alibij/SolderingIronController/Schematic.pdf

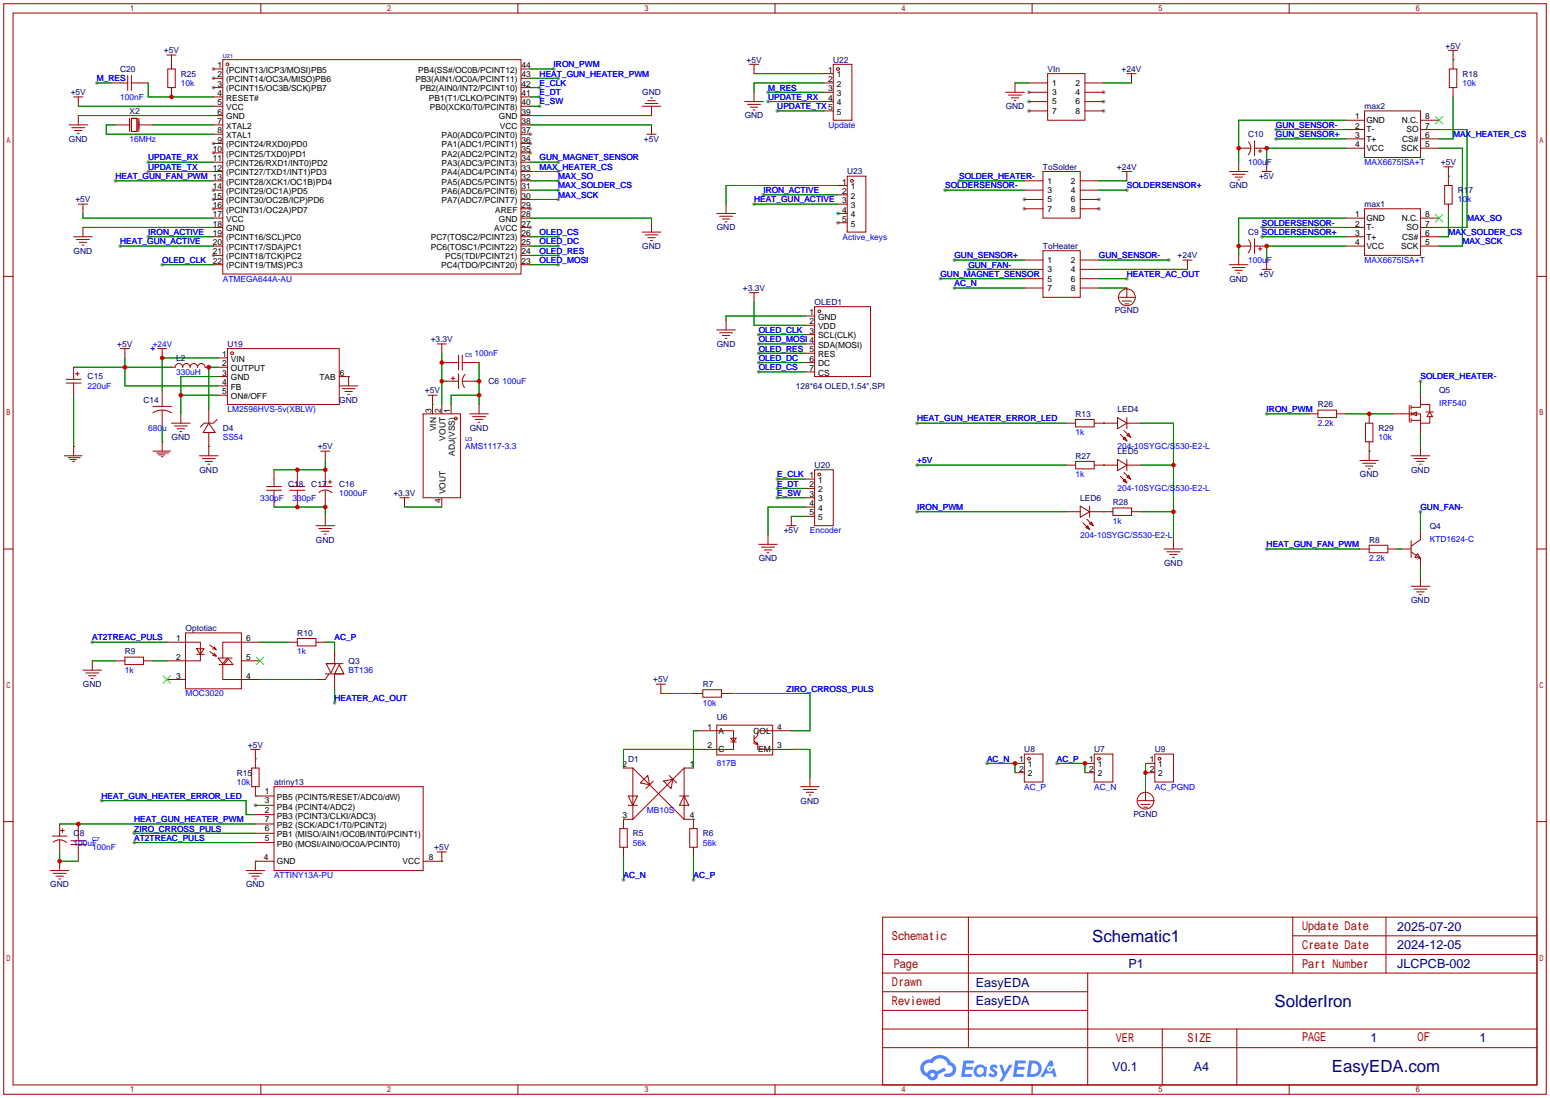
[picture p3: page 1]
