alibij/SolderingIronController/PCB.pdf

J1

R5 | Q4 R⁶ | R7

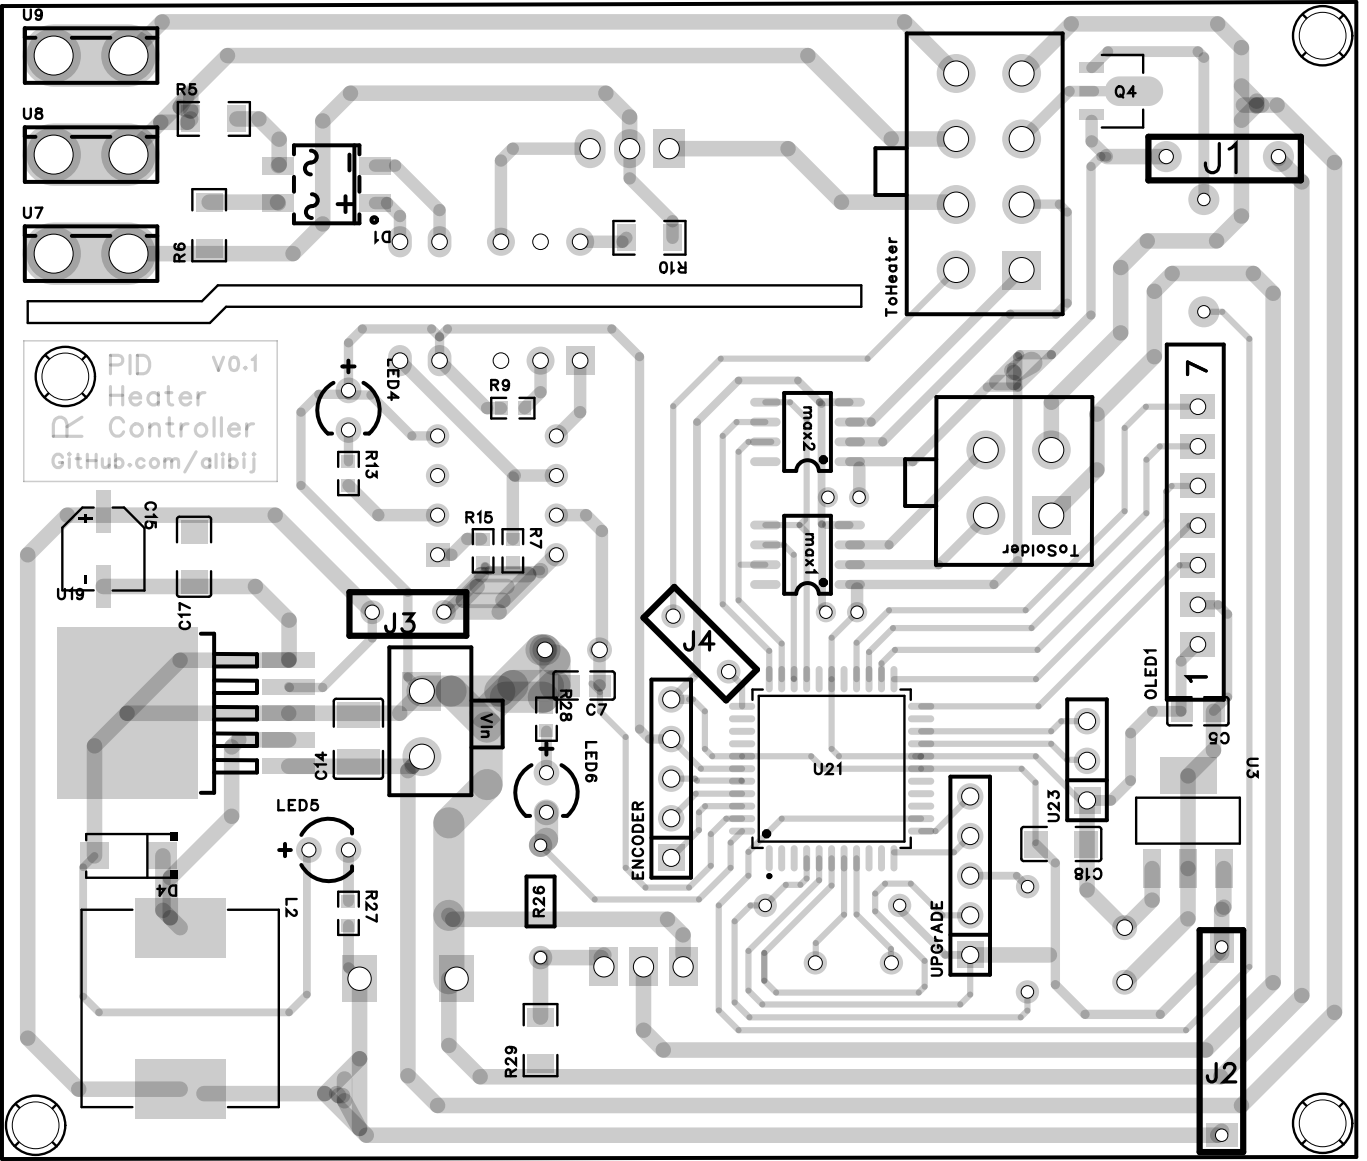
[picture p4: page 1]

# Optotiac

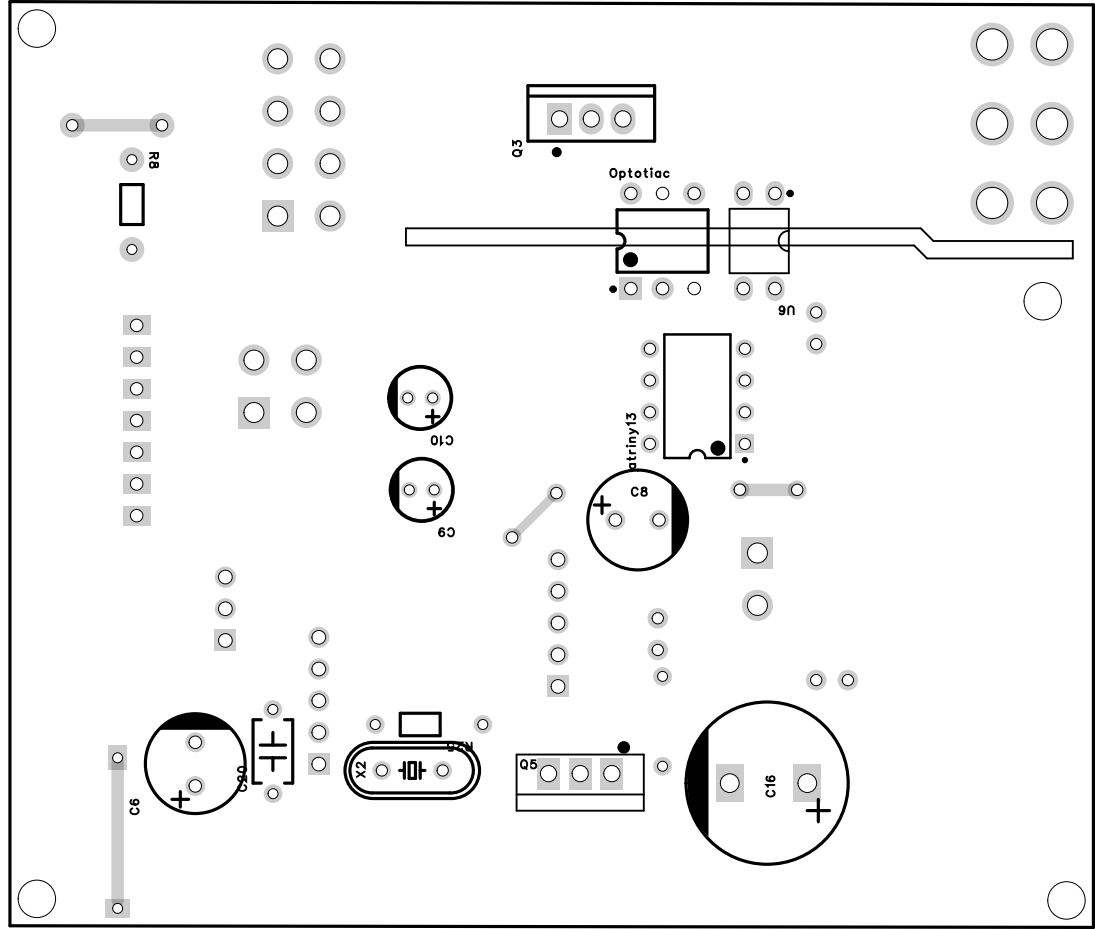
[picture p5: page 2]

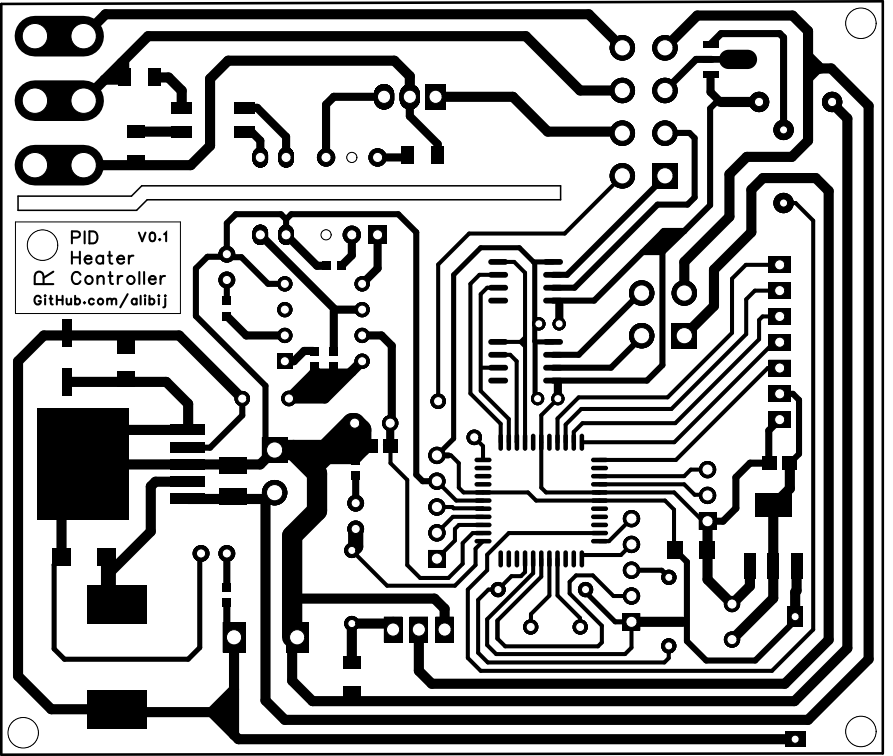
[picture p6: page 3]

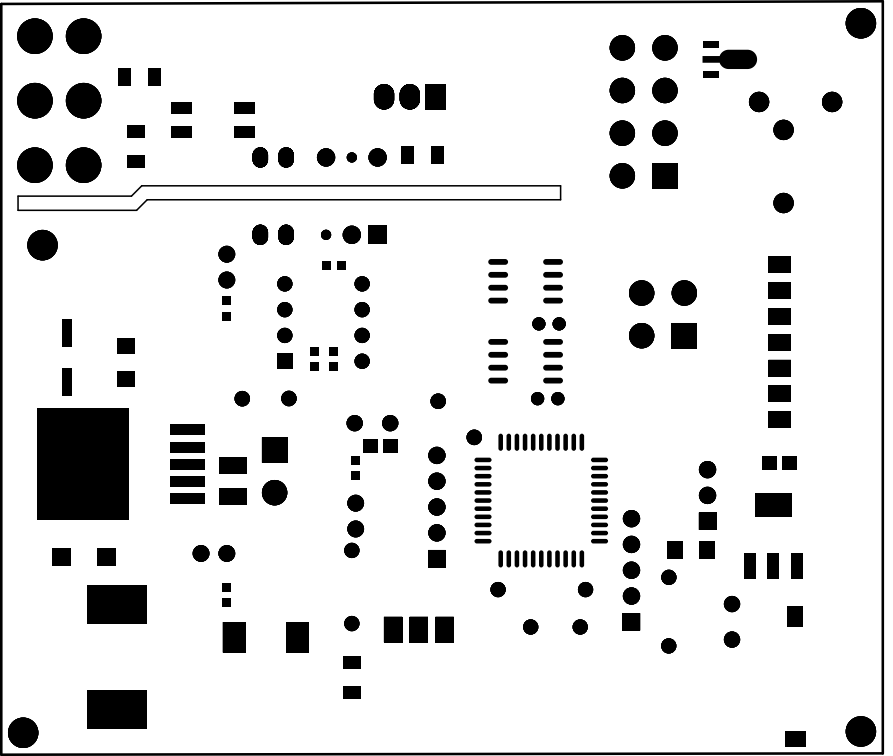
[picture p7: page 4]
