alibij/SolderingIronController/(commit log)

2024-11-20 Add heater_main.ino
2024-11-23 fix eeprom lost data
    [heater_main.ino]
2024-12-07 remove Serial print
2024-12-07 change oled I2C to SPI
2024-12-07 update pin config
2024-12-07 add heater to readme
2024-12-07 add heater and update GUI
2025-07-20 add heater controller and add menu update
2025-07-20 add bom list
    [bom_list.csv]
2025-07-20 add PCB and CSH
2025-10-10 set defult fan pwm to 50
2025-10-10 fix apply power bug
2025-10-10 fix switch case break
